jonata30-hub/Cubo-Viola/immagini/retro_con_griglia.png

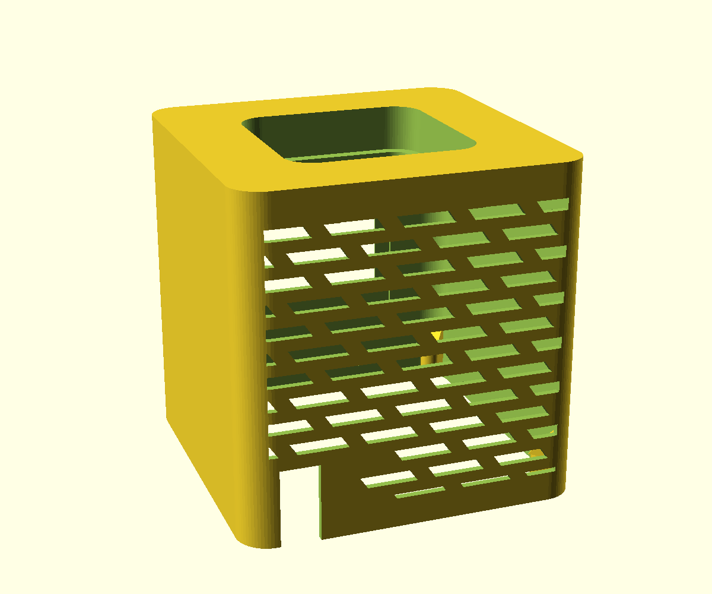
immagini/retro_con_griglia.png
