jonata30-hub/Cubo-Viola/3d/cubo_corpo.step

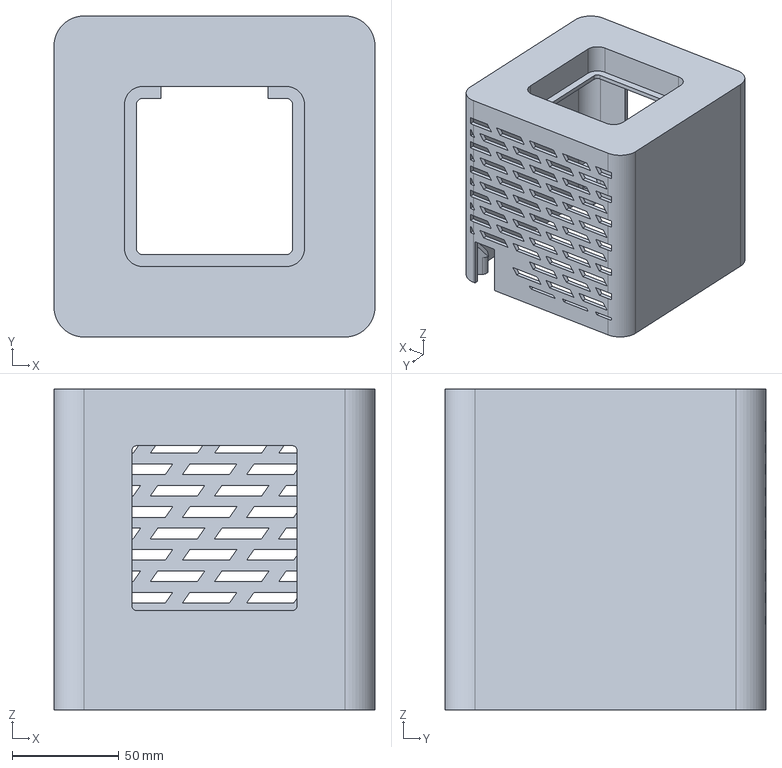
[picture p5: CAD file, 2026-10-13]
3d/cubo_corpo.step
150.0 x 150.0 x 150.0 mm
