jonata30-hub/Cubo-Viola/3d/cubo_fondo.step

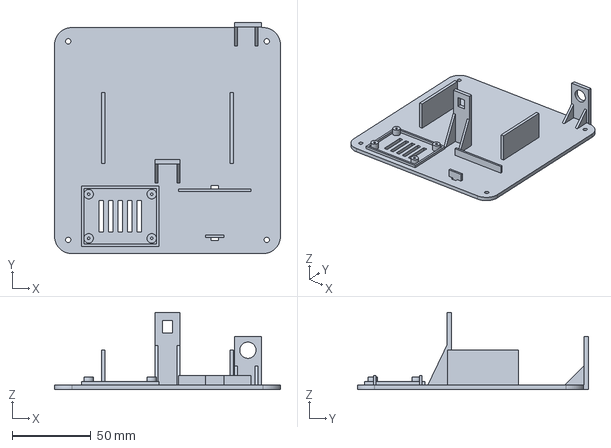
[picture p6: CAD file, 2026-10-13]
3d/cubo_fondo.step
143.4 x 146.7 x 49.0 mm
