jonata30-hub/Cubo-Viola/3d/cubo_corpo_scritta.step

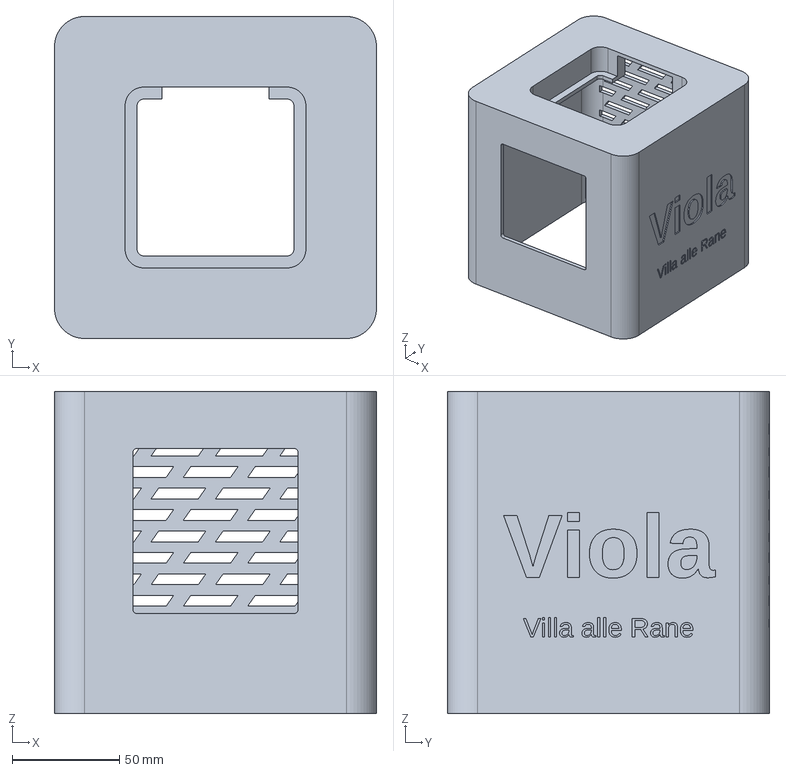
[picture p7: CAD file, 2026-10-13]
3d/cubo_corpo_scritta.step
150.0 x 150.0 x 150.0 mm
