jonata30-hub/Cubo-Viola/(list of files, cad)

Other CAD files:
3d/cubo_corpo.stl
3d/cubo_corpo_scritta.stl
3d/cubo_fondo.stl
